PSOC-31/boumbot/Doc/Presentation-Etalonnage.md

Cette partie permet de mesurer les valeurs des capteurs de ligne et de mémoriser la valeur de réponse sur du blanc et sur du noir, et ce pour chaque capteur. Ces valeurs sont mémorisée dans une zone non-impactée par les changements de programme sur la Arduino Uno

Pour procéder à cet étalonnage, charger le programme "EtalonnageBoumBot" dans le dossier "Utilitaires" et laissez-vous guider par les instructions affichées dans le moniteur série Arduino.
