PSOC-31/boumbot/Doc/Baches/BATBOUCLE.pdf

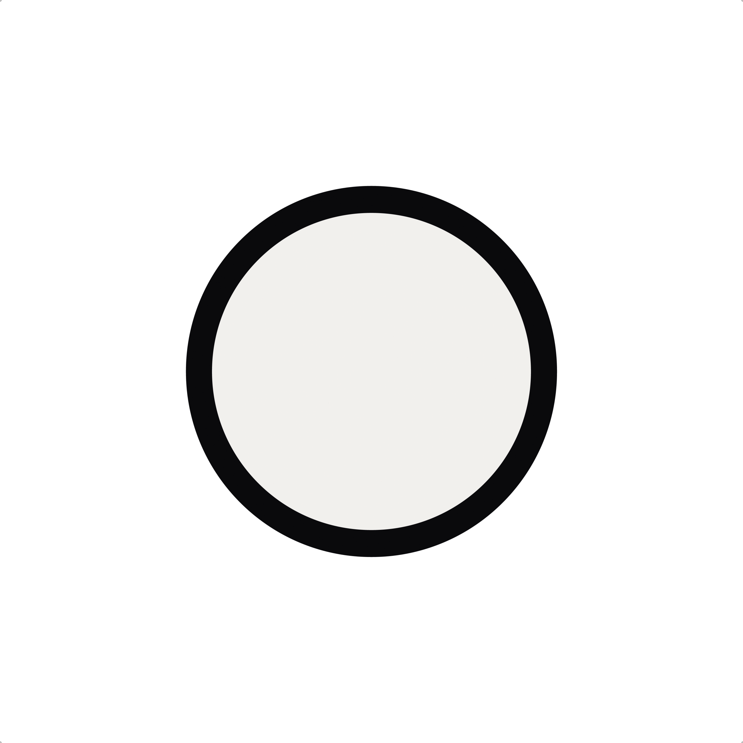
[picture p68: page 1]
