PSOC-31/boumbot/Doc/Baches/BATgRILLE.pdf

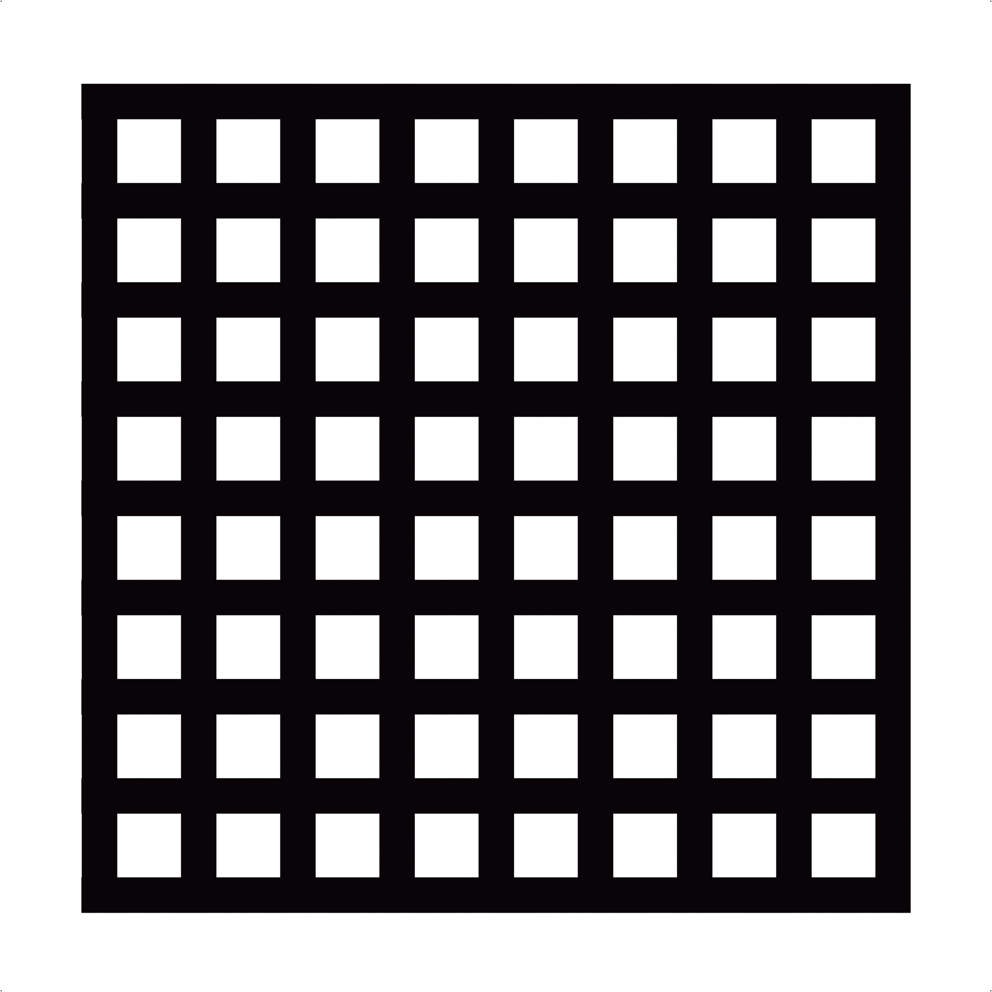
[picture p69: page 1]
