PSOC-31/boumbot/Doc/Baches/BATL.pdf

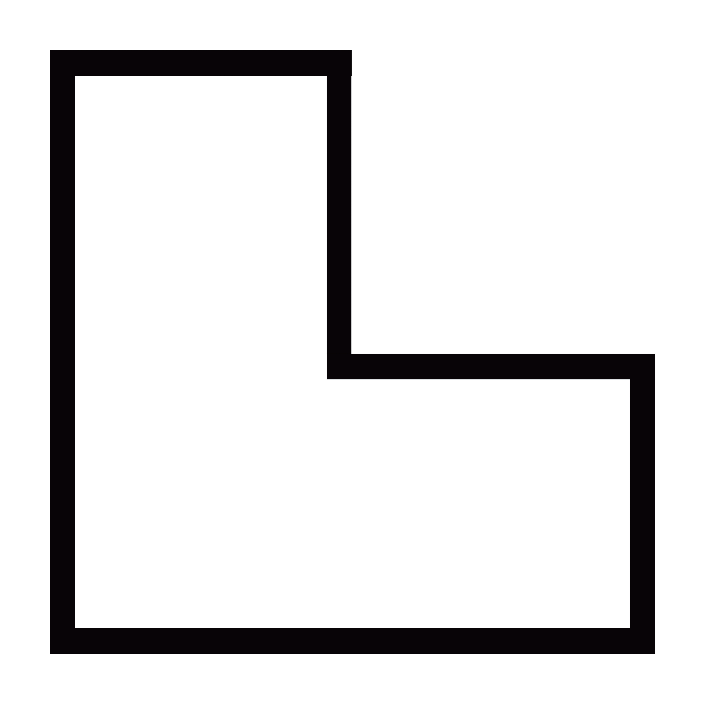
[picture p70: page 1]
