PSOC-31/boumbot/Doc/Baches/BATLIGNE.pdf

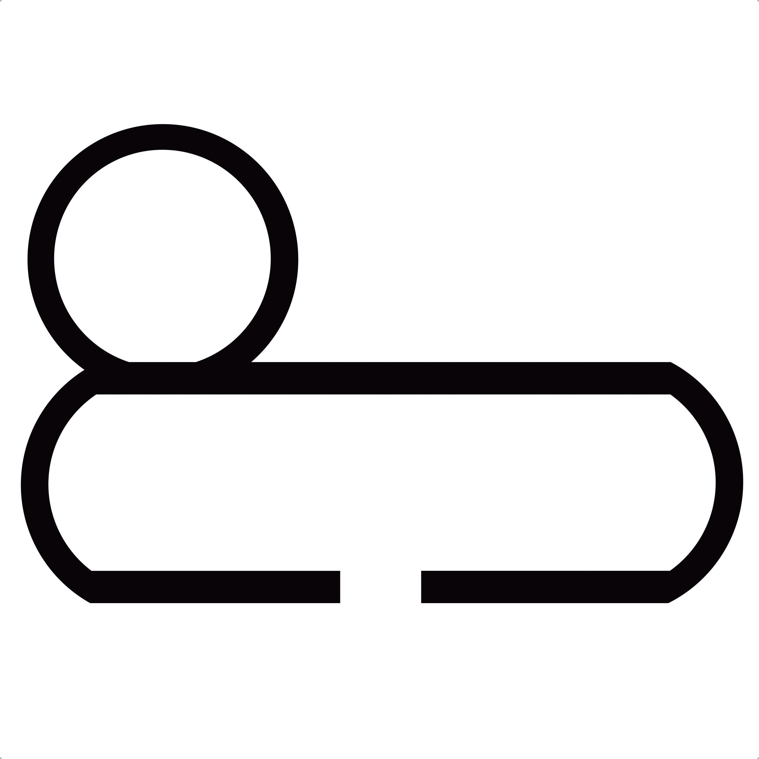
[picture p71: page 1]
