PSOC-31/boumbot/Doc/PlansMecaAchats/MaterielBoumBotGoTronic.ods

Sheet: Nouvelle version
 |  |  | 84,8
Quoi | Quantité | PU TTC | PT TTC | Référence | Fournisseur 1
Carte DFRduino R3 | 1 | 18,5 | 18,5 | DFR0216 | https://www.gotronic.fr/art-carte-dfrduino-uno-r3-dfr0216-20306.htm
Shield E/S Gravity V7 DFR0265 | 1 | 14,5 | 14,5 | DFR0265 | https://www.gotronic.fr/art-shield-e-s-gravity-v7-dfr0265-19268.htm
Servomoteurs | 2 | 9,95 | 19,9 | S04NFW | https://www.gotronic.fr/art-servo-roue-s04nfw-23322.htm
Capteur de distance infrarouge | 1 | 9,9 | 9,9 | Sharp GP2Y0A21YK0F | https://www.gotronic.fr/art-capteur-de-mesure-sharp-gp2y0a21yk0f-11539.htm
Capteurs de lignes (gray scale sensor) | 2 | 4,9 | 9,8 | DFR0022 | https://www.gotronic.fr/art-capteur-de-niveaux-de-gris-gravity-dfr0022-19286.htm
Potentiomètre rotatif | 2 | 4,1 | 8,2 | DFR0054 | https://www.gotronic.fr/art-module-potentiometre-gravity-dfr0054-19304.htm
Haut parleur | 1 | 1,5 | 1,5 | TVF 05490 | https://www.gotronic.fr/art-capsule-piezoelectrique-tvf-3851.htm
Cables USB | 1 | 2,5 | 2,5 | CW090B | https://www.gotronic.fr/art-cordon-3m-cw090b-15250.htm
Vis M3x12 + écrou | 14
Vis M3x16 (de 16 à 20) + écrou | 4
Vis M2x10 (de 8 à 12) + écrou | 1
Vis M2x20 + écrou | 1
Cable numerique pour haut parleur
Domino
https://www.gotronic.fr/art-carte-arduino-uno-12420.htm
https://www.gotronic.fr/art-10-cables-pour-capteurs-digitaux-gravity-19408.htm
https://www.gotronic.fr/art-10-cables-pour-capteurs-analogiques-gravity-19410.htm

Sheet: ancienne version
Matériel du robot Boum'Bot développé par Planète Sciences
http://www.planete-sciences.org/robot/boumbot
MAJ 07/12/2014
Ce fichier est sous licence CC BY-NC-SA 2.0 ( https://creativecommons.org/licenses/by-nc-sa/2.0/fr/ )
Quoi | Quantite | Fournisseur
Carte DFRduino R3 | 1 | http://www.dfrobot.com/index.php?route=product/product&product_id=838&search=dfrduino&description=true
I/O expansion shield V7.1 | 1 | http://www.dfrobot.com/index.php?route=product/product&product_id=1009&search=expansion+shield
Servo arobose | 2 | http://www.arobose.com/shop/moteurs-servos-robot/116-servo-a-rotation-continue-roue.html
Capteur IR sharp | 1 | http://www.arobose.com/shop/capteurs-distance-presence-mouvement/36-module-capteur-de-distance-infrarouge-sharp-gp2d12.html
Gray scale sensor DFRobot | 2 | http://www.arobose.com/shop/capteurs-robot/95-capteur-de-niveau-de-gris-analogique.html
Piezo vissable | 1 | https://www.adafruit.com/products/1739
Cable numerique pour haut parleur | 0,1 | http://www.dfrobot.com/index.php?route=product/product&product_id=124&search=sensor+cable&description=true
Boitier de 4 piles AA | 1 | http://www.rc-diffusion.com/BOITIER-PORTE-PILES-PRISE-FUTABA-a26.html
Cables USB – ok pour la taille | 1 | http://www.arobose.com/shop/accessoires-robot/32-cable-usb-a-b.html
Potentiomètre rotatif | 2 | http://www.dfrobot.com/index.php?route=product/product&path=36&product_id=87
Clip pour pile 9V avec jack | 1 | http://www.arobose.com/shop/accessoires-robot/58-cable-alimentation-pile-9v.html
Découpe laser | 1
Domino | 1
Pic a brochette | 1
Élastique 70x5mm | 2
Vis M3x12 + écrou | 14
Vis M2x10 (de 8 à 12) + écrou | 1
Vis M2x20 + écrou | 1
Vis M3x16 (de 16 à 20) + écrou | 4
Vis à bois (fournie avec moteur) | 8
Vis fixation roue (fournie avec moteur) | 2
