PSOC-31/boumbot/Doc/PlansMecaAchats/BoumBotCorps5mm_RSv2_20150308.pdf

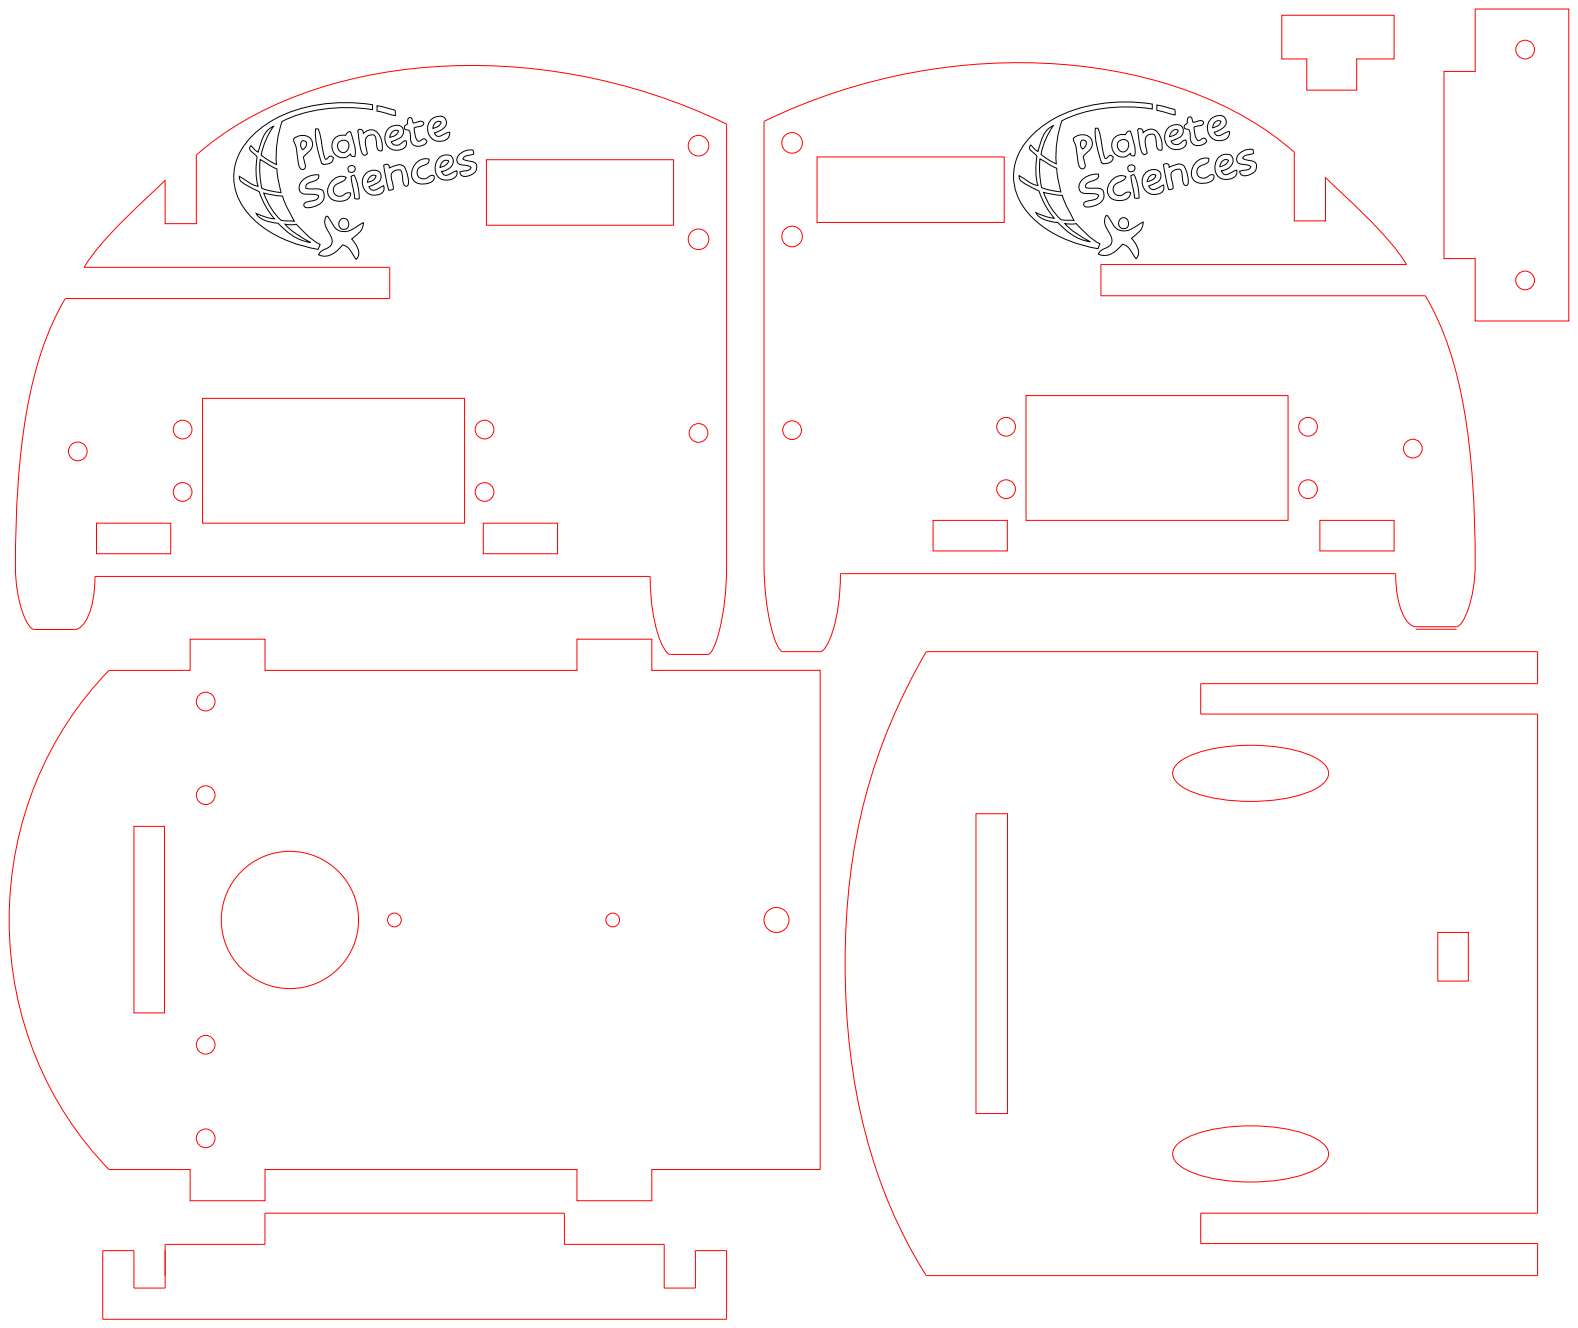
[picture p104: page 1]
