PSOC-31/boumbot/examples/Utilitaires/LecteureDebutEeprom/LecteureDebutEeprom.ino

/*
   EEPROM Read

   Reads the value of each byte of the EEPROM and prints it
   to the computer.
   This example code is in the public domain.
*/

#include <EEPROM.h>

// start reading from the first byte (address 0) of the EEPROM
int address = 0;
byte value;

void setup()
{
  // initialize serial and wait for port to open:
  Serial.begin(9600);
  while (!Serial) {
    ; // wait for serial port to connect. Needed for Leonardo only
  }
  for ( address = 0 ; address < 30 ; address ++ )
  {
    // read a byte from the current address of the EEPROM
    value = EEPROM.read(address);

    Serial.print(address);
    Serial.print("\t");
    Serial.print(value, DEC);
    Serial.println();
  }

}

void loop()
{

}
