PSOC-31/boumbot/(commit log)

2022-08-12 Etalonnage des capteurs de ligne
    Nouvelle bibliothèque pour tenir compte de la tolérance des capteurs de ligne, qui dépasse les 200% ( du simple au X8 ! ).
    Le principe est de mémoriser dans l'Eeprom de la Arduino, une zone non impactée par les changement de programme, les valeurs de ces capteurs sur le blanc et sur le noir. Ainsi, on retrouve la pleine échelle de 0 à 100 sur les valeurs affichées.
2022-08-12 Images liées à l'étalonnage et numéro de série
2022-09-26 Ajout des docs
    [MaterielBoumBotGoTronic.ods]
